tmkdev/iv9_clock/README.md

# iv9_clock
IV-9 Clock. Targeted at raspberry pi. 

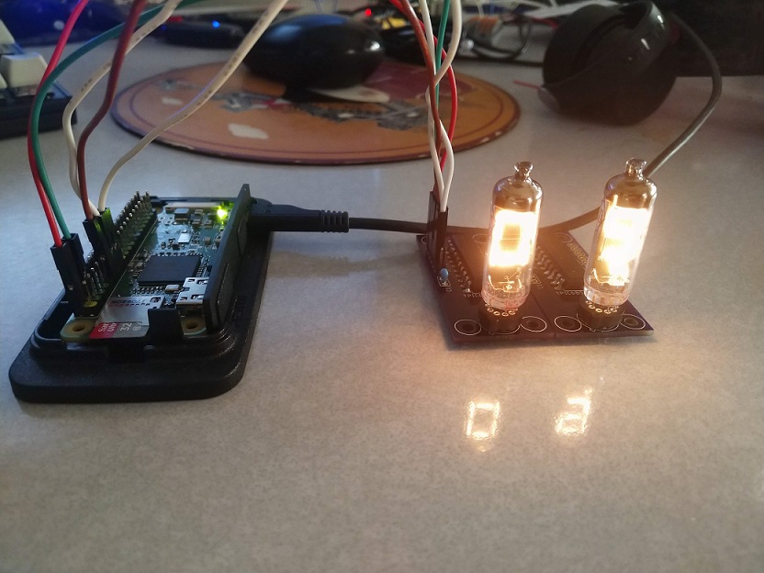
[picture p1: assets/IMG_20190324_180927.jpg]
2 Tube Clock prototype


[Video](https://photos.app.goo.gl/XQEr5hhQ3mAr3oM97)

[Completed clock gallery](https://photos.app.goo.gl/mM42fY7hRfecAtkD6)
