tmkdev/iv9_clock/cad/README.md

CAD drawings for laser cut body

ClockCase_cut_13.dxf was the file sent to ponoko for cutting. Cut in 1/8" black acrylic.
