tmkdev/iv9_clock/eagle/schematic.png

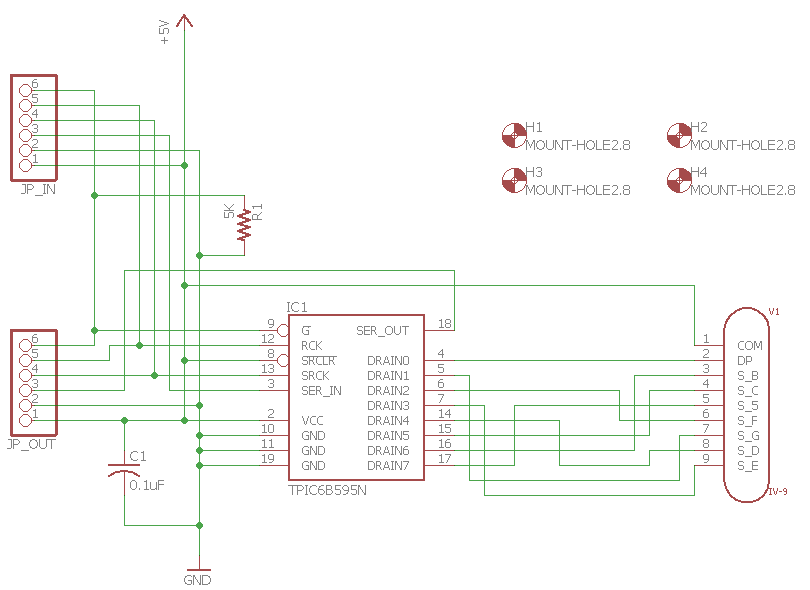
eagle/schematic.png
