tmkdev/iv9_clock/eagle/V1.1_Bottom.png

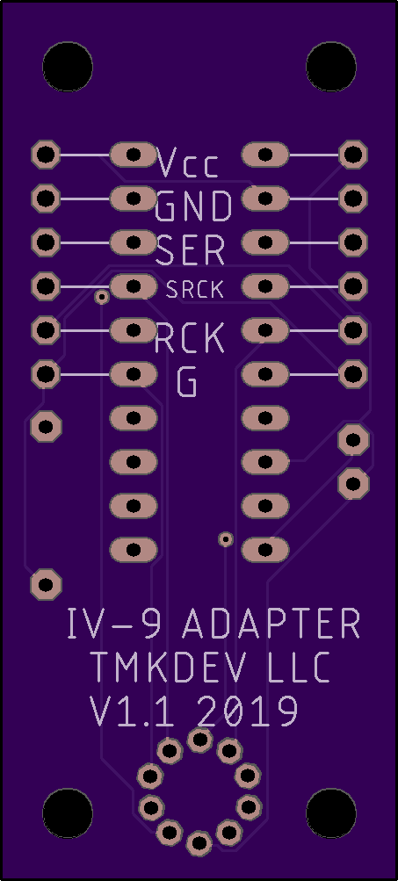
eagle/V1.1_Bottom.png
