tmkdev/iv9_clock/eagle/V1.1_Top.png

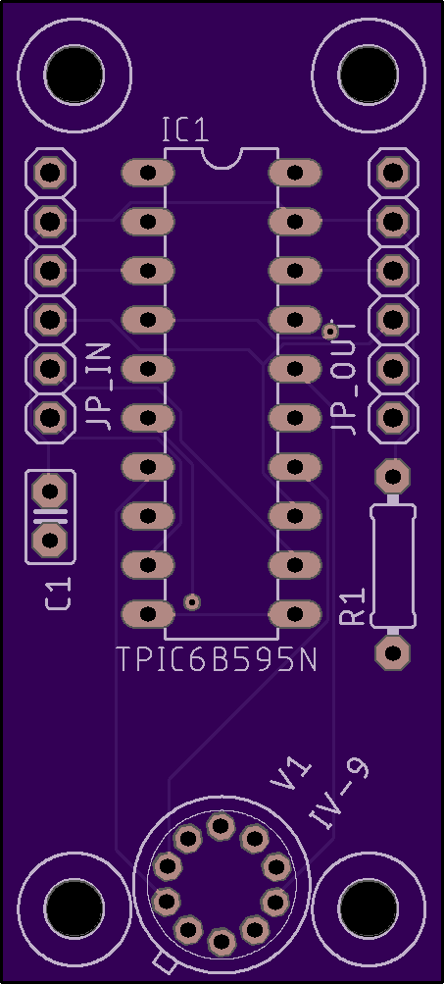
eagle/V1.1_Top.png
