tmkdev/iv9_clock/cad/ClockCase_cut_13.dxf

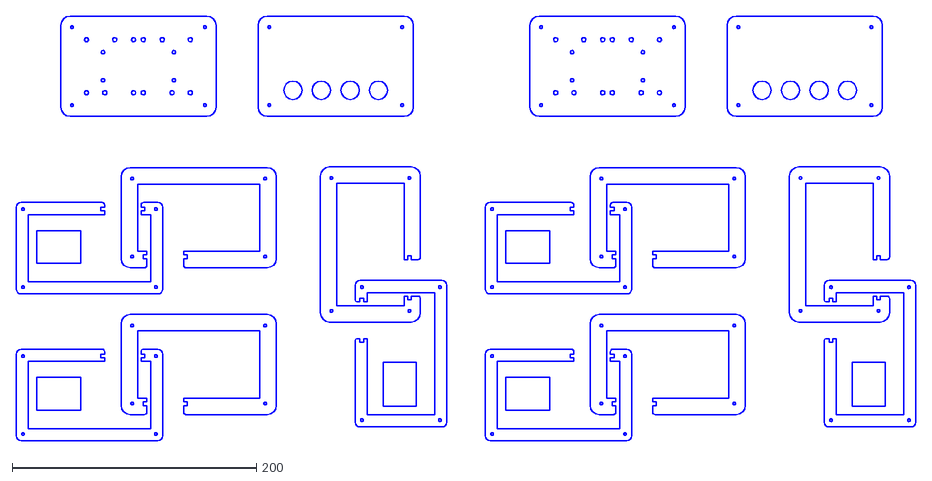
[picture p5: CAD file, 2019-07-21]
cad/ClockCase_cut_13.dxf
736.5 x 347.7
