tmkdev/iv9_clock/cad/ClockCase_cut.dxf

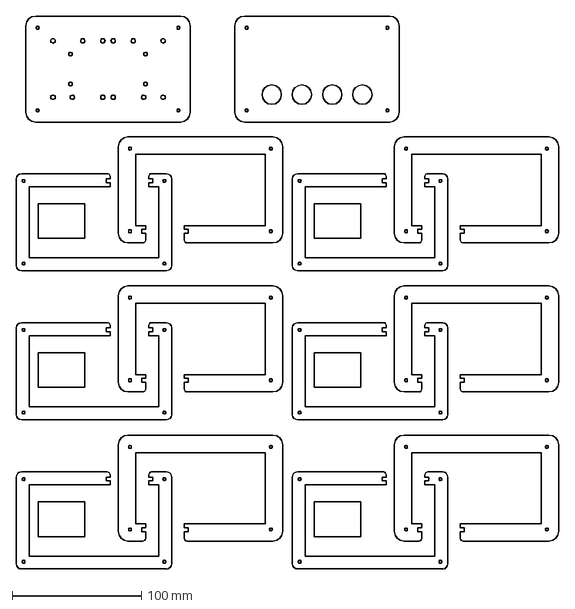
[picture p6: CAD file, 2019-07-21]
cad/ClockCase_cut.dxf
419.0 x 427.2 mm
