tmkdev/iv9_clock/(list of files, cad)

Other CAD files:
cad/ClockCase.dwg
cad/ClockCase_cut.dwg
