tmkdev/iv9_clock/eagle/Single_Driver.brd

## EAGLE design eagle/Single_Driver.brd (2019-03-24)

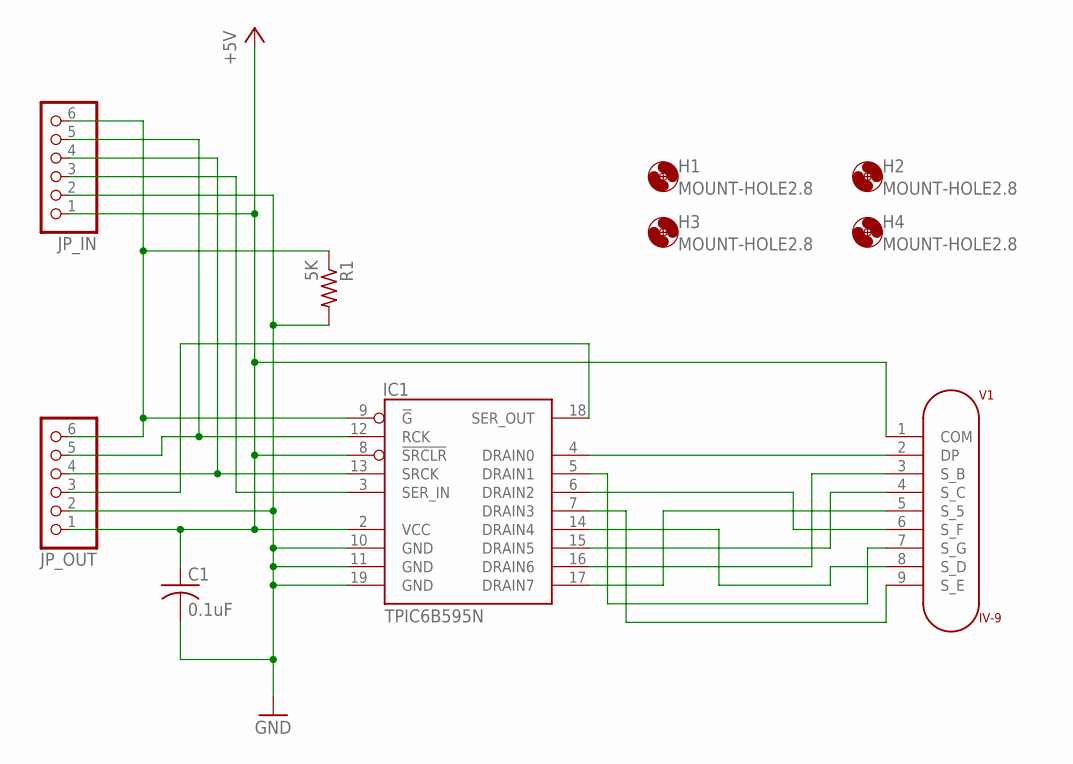
[picture p7: schematic Single_Driver.sch]

Parts:
C1: 0.1uF; C025-025X050
H1, H2, H3, H4: MOUNT-HOLE2.8; 2,8
IC1: TPIC6B595N; DIL20
JP_IN: PINHD-1X6; 1X06
JP_OUT: PINHD-1X6; 1X06
R1: 5K; 0207/9
V1: IV-9; TO100

Connections:
+5V: C1.1, IC1.2 (VCC), IC1.8 (!SRCLR), JP_IN.1, JP_OUT.1, V1.1 (COM)
GND: C1.2, IC1.10 (GND), IC1.11 (GND), IC1.19 (GND), JP_IN.2, JP_OUT.2, R1.2
unnamed: IC1.4 (DRAIN0), V1.2 (DP)
unnamed: IC1.16 (DRAIN6), V1.3 (S_B)
unnamed: IC1.15 (DRAIN5), V1.4 (S_C)
unnamed: IC1.17 (DRAIN7), V1.5 (S_5)
unnamed: IC1.6 (DRAIN2), V1.6 (S_F)
unnamed: IC1.7 (DRAIN3), V1.9 (S_E)
unnamed: IC1.14 (DRAIN4), V1.8 (S_D)
unnamed: IC1.5 (DRAIN1), V1.7 (S_G)
unnamed: IC1.9 (!G), JP_IN.6, JP_OUT.6, R1.1
RCLK: IC1.12 (RCK), JP_IN.5, JP_OUT.5
SER_IN: IC1.3 (SER_IN), JP_IN.3
SER_OUT: IC1.18 (SER_OUT), JP_OUT.3
SRCK: IC1.13 (SRCK), JP_IN.4, JP_OUT.4

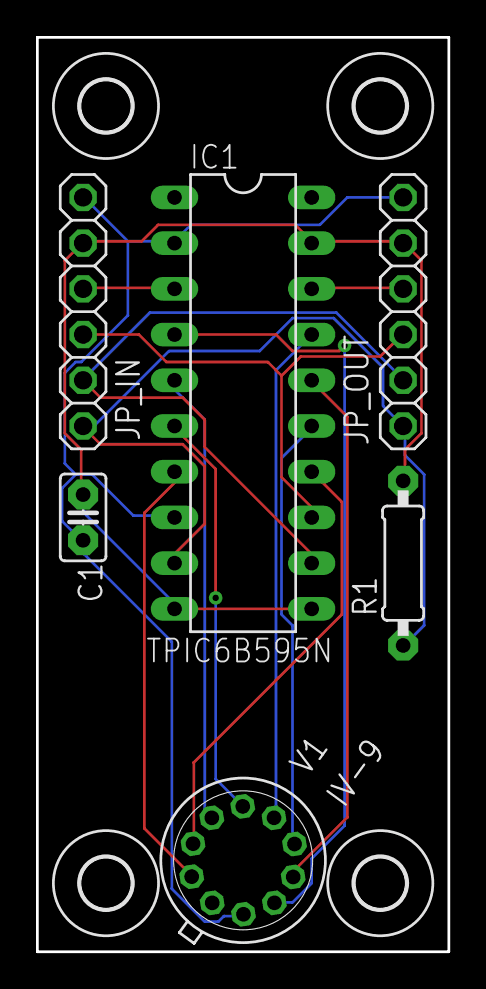
[picture p8: board Single_Driver.brd from above]

Board: 2 copper layers, 22.9 x 50.8 mm, 10 parts (0 on the bottom side), 15 nets.
