tmkdev/iv9_clock/mapping.py

import logging

#TPIC to IV9
#MSB
# DRAIN0 7 - Pin 2
# DRAIN1 6 - Pin 7
# DRAIN2 5 - Pin 6
# DRAIN3 4 - Pin 9
# DRAIN4 3 - Pin 8
# DRAIN5 2 - Pin 4
# DRAIN6 1 - Pin 3
# DRAIN7 0 - Pin 5
#LSB
    

segment_map = {
  " ": 0x00,   #0x20 ' '
  "!": 0x86,   #0x21 '!'
  "\"": 0x22,   #0x22 '"'
  "#": 0x7E,   #0x23 '#' ?
  "$": 0x2D,   #0x24 '$' ?
  "%": 0xD2,   #0x25 '%' ?
  "&": 0x7B,   #0x26 '&' ?
  "'": 0x20,   #0x27 '''
  "(": 0x39,   #0x28 '('
  ")": 0x0F,   #0x29 ')'
  "*": 0x63,   #0x2A '*' ?
  "+": 0x00,   #0x2B '+' ?
  ",": 0x10,   #0x2C ','
  "-": 0x40,   #0x2D '-'
  ".": 0x80,   #0x2E '.'
  "/": 0x52,   #0x2F '/' ?
  #30-3F
  "0": 0x3F,   #0x30 '0'
  "1": 0x06,   #0x31 '1'
  "2": 0x5B,   #0x32 '2'
  "3": 0x4F,   #0x33 '3'
  "4": 0x66,   #0x34 '4'
  "5": 0x6D,   #0x35 '5'
  "6": 0x7D,   #0x36 '6'
  "7": 0x07,   #0x37 '7'
  "8": 0x7F,   #0x38 '8'
  "9": 0x6F,   #0x39 '9'
  ":": 0x09,   #0x3A ':' ?
  ";": 0x0D,   #0x3B ';' ?
  "<": 0x58,   #0x3C '<' ?
  "=": 0x48,   #0x3D '='
  ">": 0x4C,   #0x3E '>' ?
  "?": 0xD3,   #0x3F '?' ?
  #40-4F
  "@": 0x5F,   #0x40 '@' ?
  "A": 0x77,   #0x41 'A'
  "B": 0x7C,   #0x42 'B'
  "C": 0x39,   #0x43 'C'
  "D": 0x5E,   #0x44 'D'
  "E": 0x79,   #0x45 'E'
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
  "X": 0x76,   #0x58 'X' ? (like H)
  "Y": 0x6E,   #0x59 'Y'
  "Z": 0x5B,   #0x5A 'Z' ?
  "[": 0x39,   #0x5B '['
  "\\": 0x64,   #0x5C '\' ?
  "]": 0x0F,   #0x5D ']'
  "^": 0x23,   #0x5E '^' ?
  "_": 0x08,   #0x5F '_'
  #60-6F
  "`": 0x02,   #0x60 '`' ?
  "a": 0x77,   #0x61 'a'
  "b": 0x7C,   #0x62 'b'
  "c": 0x58,   #0x63 'c'
  "d": 0x5E,   #0x66 'd'
  "e": 0x79,   #0x65 'e'
  "f": 0x71,   #0x66 'f'
  "g": 0x3D,   #0x67 'g'
  "h": 0x74,   #0x68 'h'
  "i": 0x10,   #0x69 'i'
  "j": 0x1E,   #0x6A 'j'
  "k": 0x75,   #0x6B 'k' ?
  "l": 0x38,   #0x6C 'l'
  "m": 0x37,   #0x6D 'm'
  "n": 0x54,   #0x6E 'n'
  "o": 0x5C,   #0x6F 'o'
  #70-7F
  "p": 0x73,   #0x70 'p'
  "q": 0x67,   #0x71 'q'
  "r": 0x50,   #0x72 'r'
  "s": 0x6D,   #0x73 's'
  "t": 0x78,   #0x74 't'
  "u": 0x3E,   #0x77 'u' ? (like U)
  "v": 0x1C,   #0x76 'v' ? (like u)
  "w": 0x2A,   #0x77 'w' ?
  "x": 0x76,   #0x78 'x' ? (like H)
  "y": 0x6E,   #0x79 'y'
  "z": 0x5B,   #0x7A 'z' ?
  "{": 0x46,   #0x7B '{' ?
  "|": 0x30,   #0x7C '|'
  "}": 0x70,   #0x7D '}' ?
  "~": 0x01,   #0x7E '~' ?
  "DEL": 0x00,   #0x7F 'DEL'
};


def converttoarray(byteval):
    b = [byteval >> i & 1 for i in range(7,-1,-1)]
    b.reverse()

    return b


def str_rep(byteval):
    b = converttoarray(byteval)

    ascii='   \n'

    #Seg a - Pin 5
    if b[0]:
        ascii='+-+\n'

    #Seg f - Pin 6
    if b[5]:
        ascii+='| '
    else:
        ascii+='  '

    #Seg b - Pin 3
    if b[1]:
        ascii+='|\n'
    else:
        ascii+=' \n'

    #Seg g - Pin 7
    if b[6]:
        ascii+='+-+\n'
    else:
        ascii+='   \n'

    #Seg e- Pin 9
    if b[4]:
        ascii+='| '
    else:
        ascii+='  '

    #Seg c- Pin 4
    if b[2]:
        ascii+='|\n'
    else:
        ascii+=' \n'

    #Seg d- Pin 8
    if b[3]:
        ascii+='+-+'
    else:
        ascii+='   '

    #MSB
    #Seg .- Pin 2
    if b[7]:
        ascii +='.\n'
    else:
        ascii +='\n'

    return ascii


if __name__ == '__main__':
    for num in ['1', '2', '5', '9']:
        char = segment_map[str(num)]
        print('{0:b}'.format(char))
        print(str_rep(char))
        
