tmkdev/iv9_clock/(commit log)

2019-03-10 Added IV-9 Pin mapps in comments
2019-03-24 Adding eagle files to project
    [Single_Driver.brd, Single_Driver.sch]
2019-03-24 Ready to test on Raspberry pi..
2019-04-06 Added a single tube tester..
2019-04-09 add video of tube test
2019-07-20 Added switches for am/pm milltime and seconds indicator. modified: clock.py
2019-07-21 CAD files
    [ClockCase.dwg, ClockCase_cut.dwg, ClockCase_cut.dxf, ClockCase_cut_13.dxf]
2019-07-21 Added schematic png
